BoNoam/EMG-Nerf-Gun/Mechanical/Loading Mechanism.png

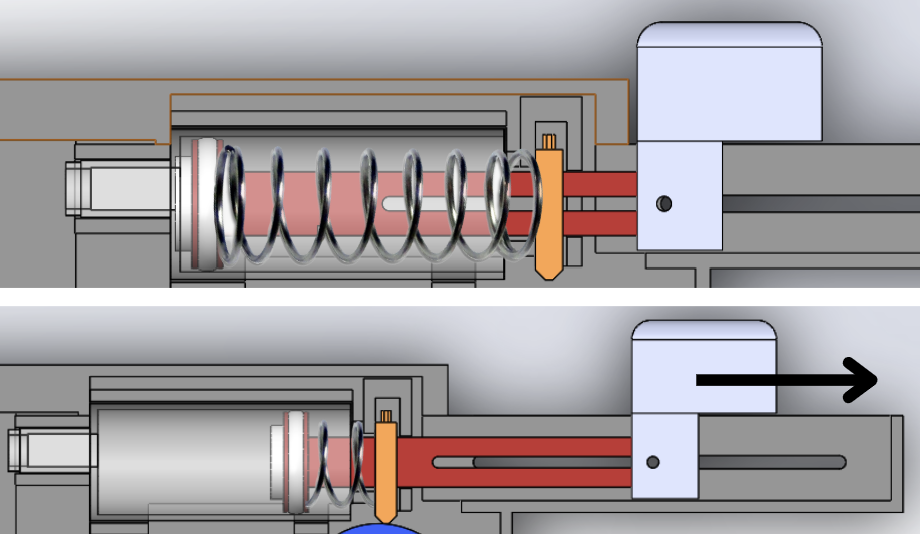
Mechanical/Loading Mechanism.png
