BoNoam/EMG-Nerf-Gun/Mechanical/Assembled Picture.png

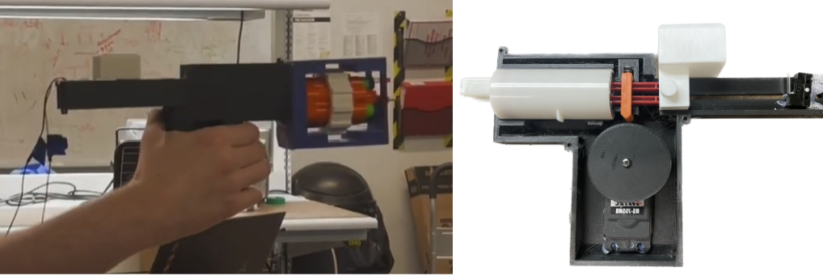
Mechanical/Assembled Picture.png
