BoNoam/EMG-Nerf-Gun/README.md

# EMG-Nerf-Gun
EMG activated Nerf gun project.
