BoNoam/EMG-Nerf-Gun/Circuitry/60 Hz Notch Filter Circuit.png

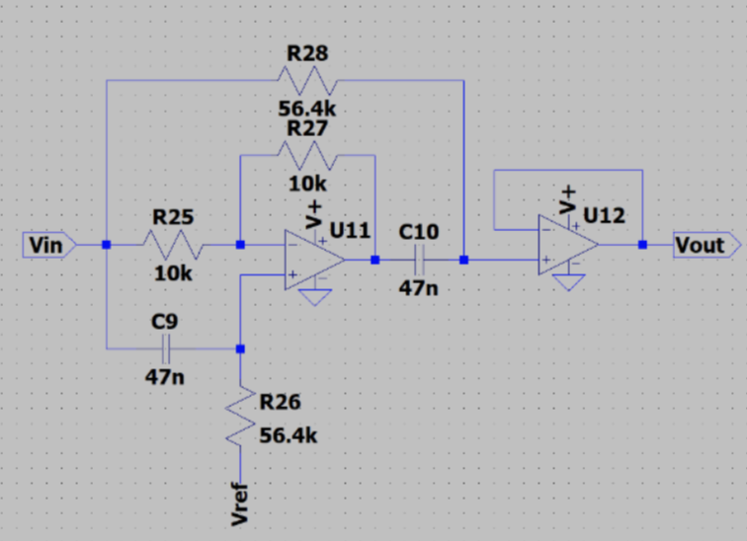
Circuitry/60 Hz Notch Filter Circuit.png
