BoNoam/EMG-Nerf-Gun/Circuitry/Bode Plots.png

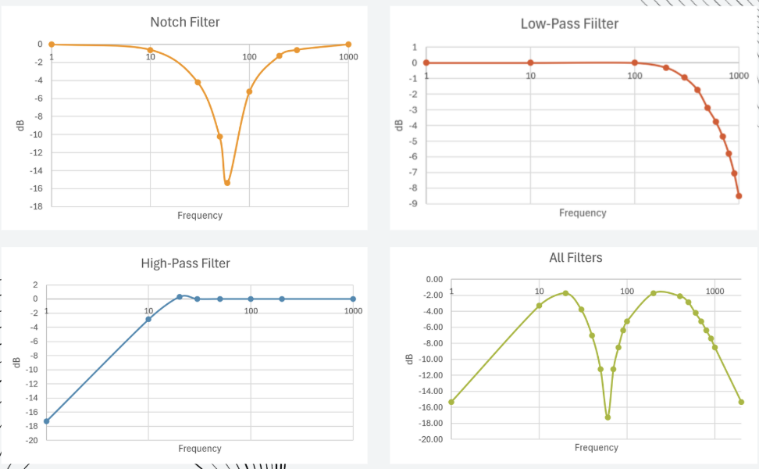
Circuitry/Bode Plots.png
