BoNoam/EMG-Nerf-Gun/Circuitry/Cascaded Low Pass - High Pass Filter Circuit.png

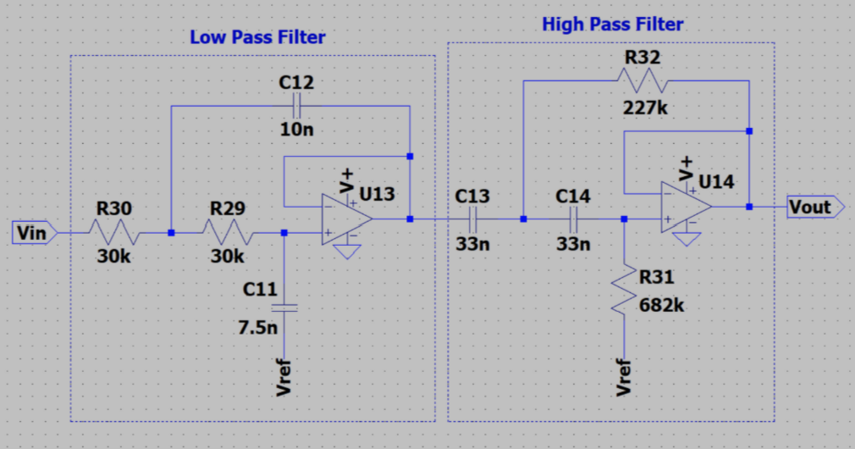
Circuitry/Cascaded Low Pass - High Pass Filter Circuit.png
