BoNoam/EMG-Nerf-Gun/Circuitry/Envelope Detector Circuit.png

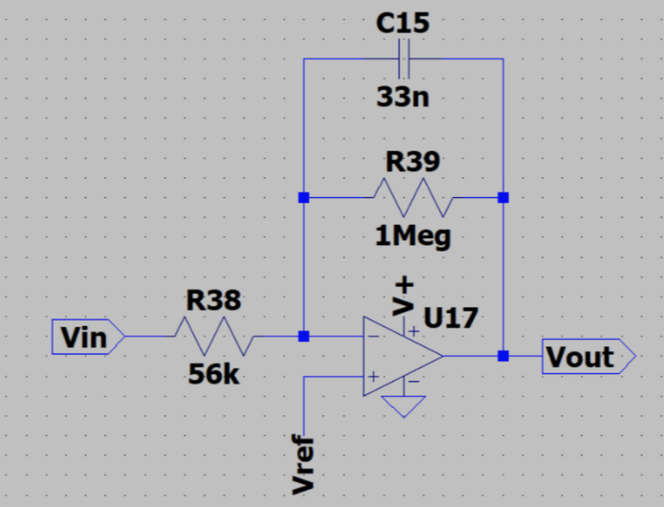
Circuitry/Envelope Detector Circuit.png
