BoNoam/EMG-Nerf-Gun/Circuitry/Full Circuit.png

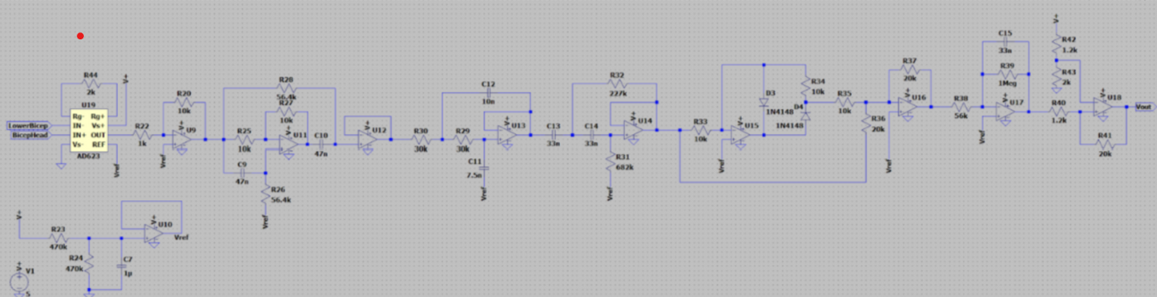
Circuitry/Full Circuit.png
