BoNoam/EMG-Nerf-Gun/Circuitry/Full Wave Rectifier Circuit.png

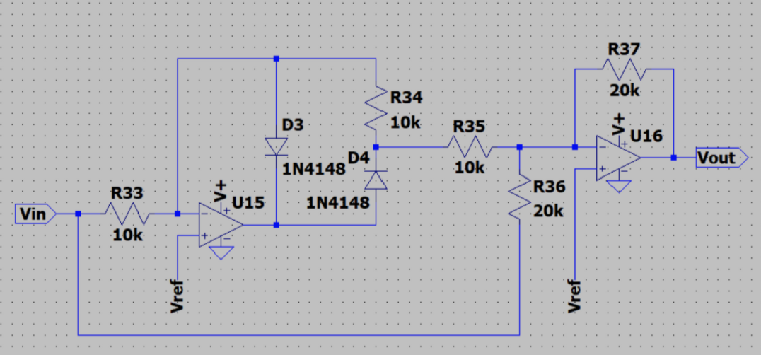
Circuitry/Full Wave Rectifier Circuit.png
