BoNoam/EMG-Nerf-Gun/Circuitry/IA Circuit.png

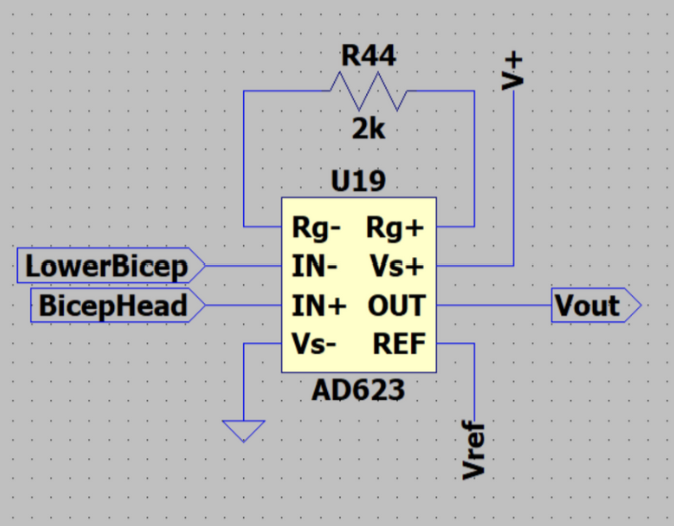
Circuitry/IA Circuit.png
