BoNoam/EMG-Nerf-Gun/Circuitry/Non Inverting Schmitt Trigger Circuit.png

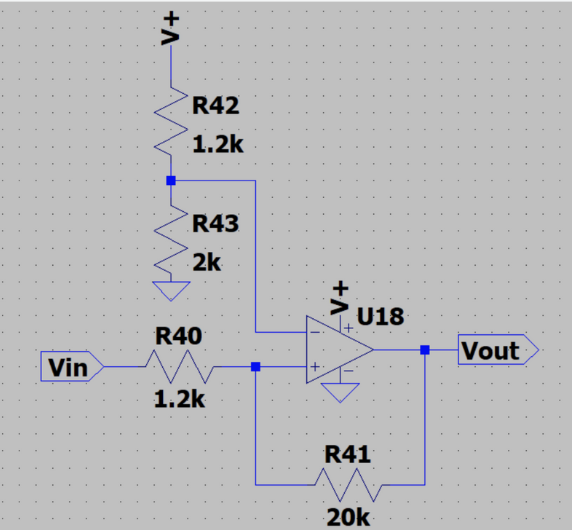
Circuitry/Non Inverting Schmitt Trigger Circuit.png
