BoNoam/EMG-Nerf-Gun/Mechanical/CAM Release Mechanism.png

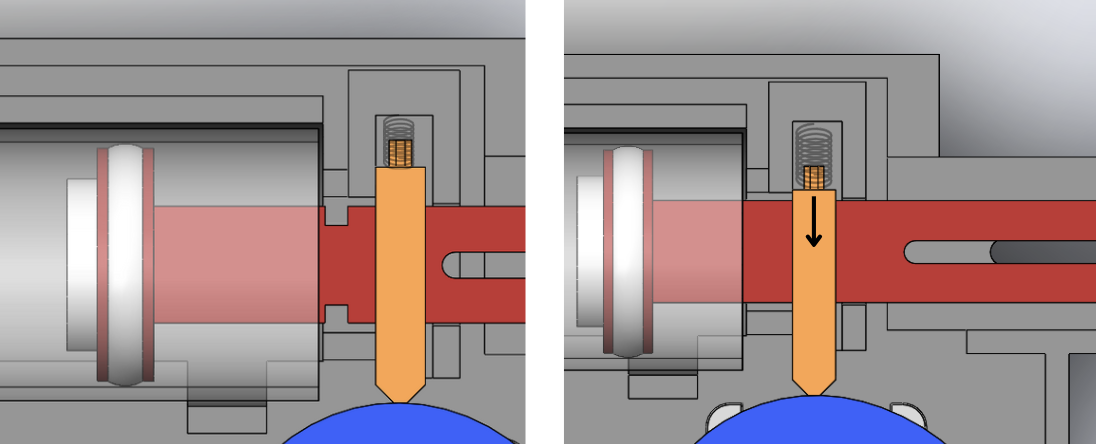
Mechanical/CAM Release Mechanism.png
