BoNoam/EMG-Nerf-Gun/Mechanical/CAD/Casing Half 1.SLDPRT

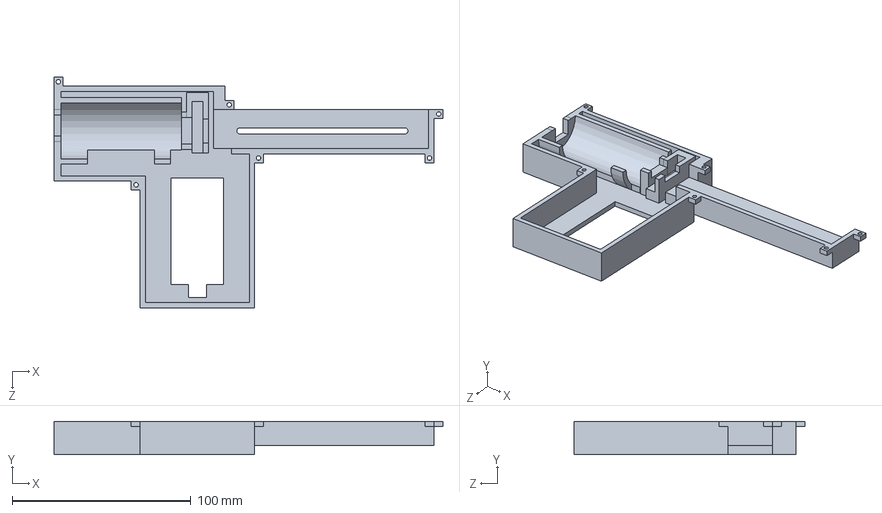
[picture p12: CAD file, 2025-09-16]
Mechanical/CAD/Casing Half 1.SLDPRT
217.8 x 18.6 x 129.0 mm
