BoNoam/EMG-Nerf-Gun/Mechanical/CAD/Cylinder.SLDPRT

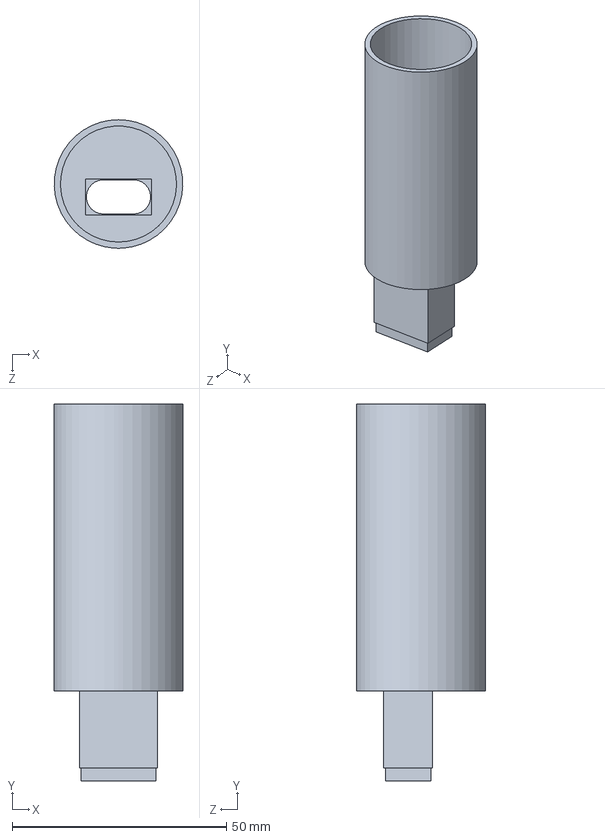
[picture p13: CAD file, 2025-09-16]
Mechanical/CAD/Cylinder.SLDPRT
30.0 x 88.0 x 30.0 mm
