BoNoam/EMG-Nerf-Gun/Mechanical/CAD/Baby Frame.SLDPRT

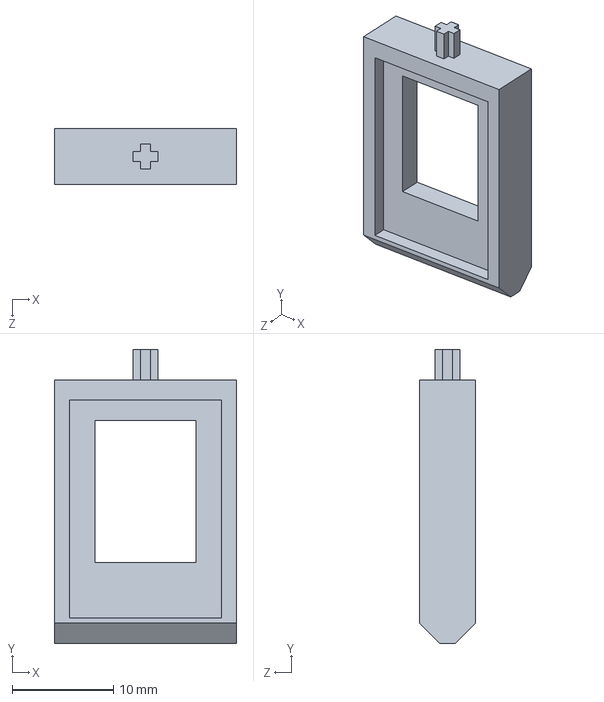
[picture p14: CAD file, 2025-09-16]
Mechanical/CAD/Baby Frame.SLDPRT
18.0 x 29.0 x 5.50 mm
