BoNoam/EMG-Nerf-Gun/Mechanical/CAD/Magazine Half 1.SLDPRT

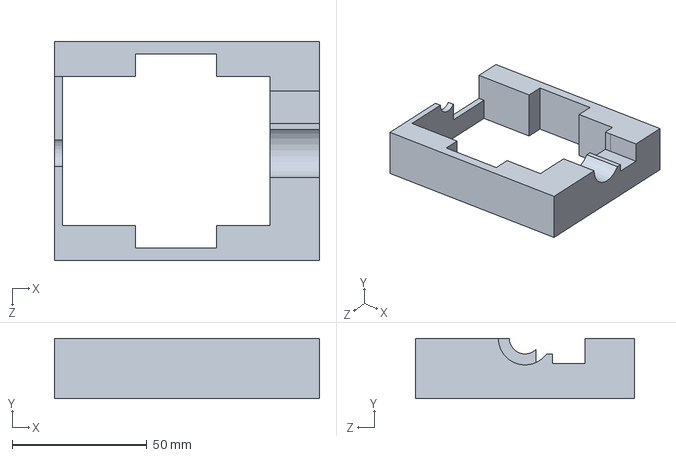
[picture p15: CAD file, 2025-09-16]
Mechanical/CAD/Magazine Half 1.SLDPRT
98.3 x 22.4 x 81.3 mm
