BoNoam/EMG-Nerf-Gun/Mechanical/CAD/Turn Grip.SLDPRT

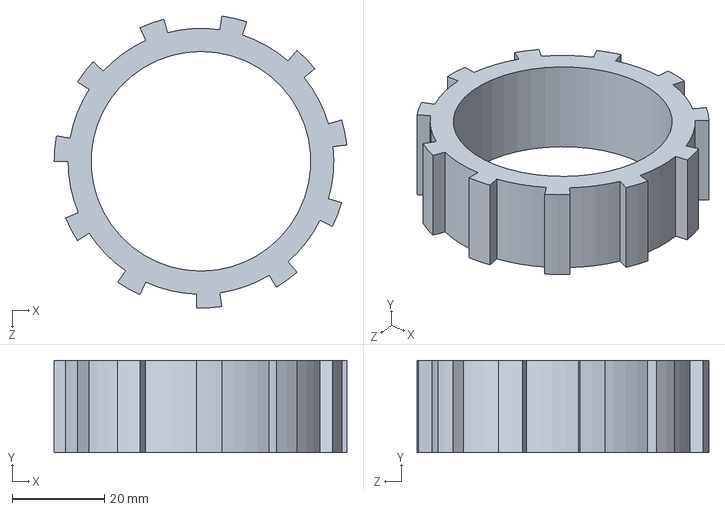
[picture p16: CAD file, 2025-09-16]
Mechanical/CAD/Turn Grip.SLDPRT
63.3 x 20.0 x 63.2 mm
