BoNoam/EMG-Nerf-Gun/Mechanical/CAD/cam 1.SLDPRT

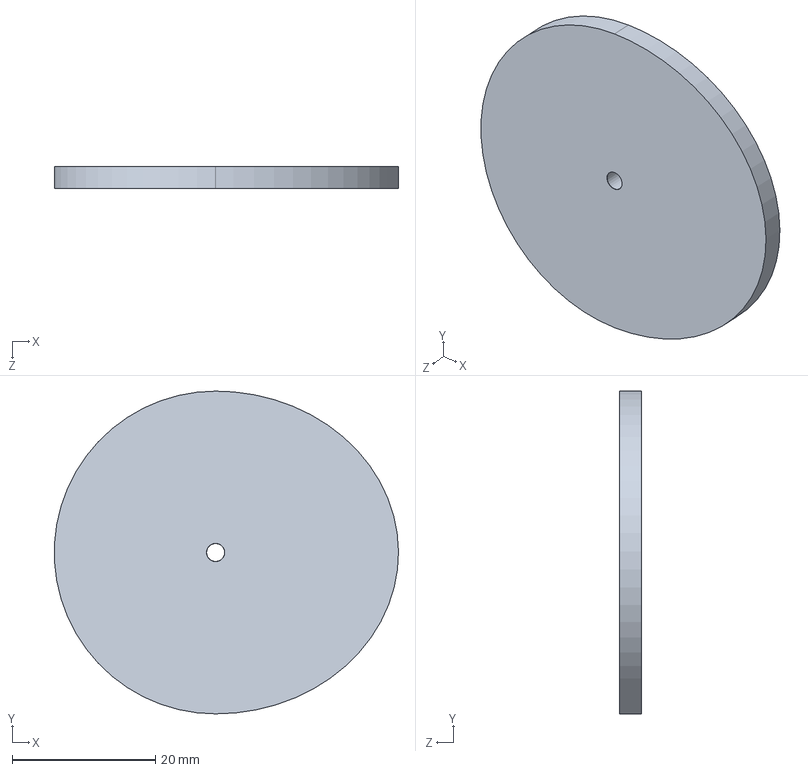
[picture p17: CAD file, 2025-09-16]
Mechanical/CAD/cam 1.SLDPRT
48.0 x 45.0 x 3.00 mm
