BoNoam/EMG-Nerf-Gun/Mechanical/CAD/Plunger.SLDPRT

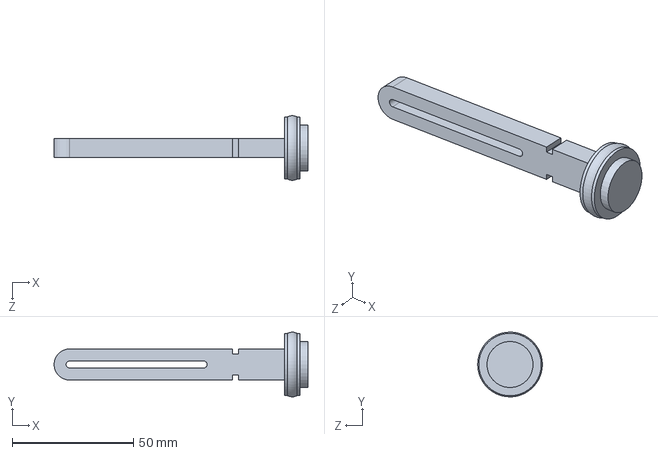
[picture p18: CAD file, 2025-09-16]
Mechanical/CAD/Plunger.SLDPRT
104.6 x 26.7 x 26.6 mm
