BoNoam/EMG-Nerf-Gun/Mechanical/CAD/Assembly.SLDASM

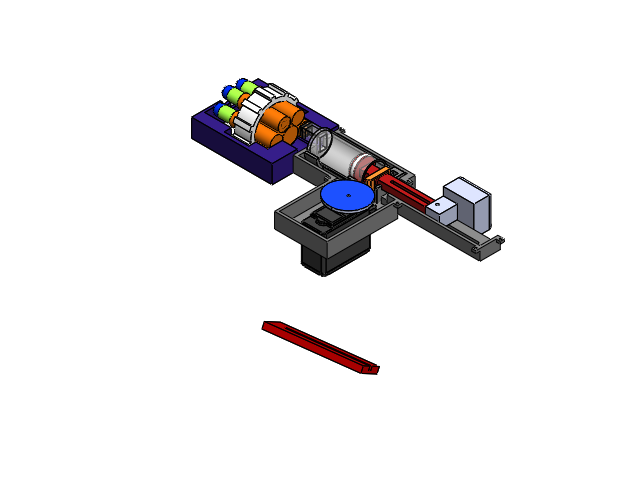
[picture p19: CAD file, 2025-09-16]
Mechanical/CAD/Assembly.SLDASM
new casing design cam edition
Cylinder Carrier
Baby Frame
Plunger
Spacer
orANGE fRAME hOLDER
_HS-755HB.stp
pull back
cam 1
casing
magazine casing
orange
turney thingyy
Nerf Gun Bullet x 4
